artashesamatuni/coreEVSE/codechange.md

# Заметки для изменений прошивки OpenEVSE

Состояние на 2026-10-01. Это план для `../coreEVSE-Soft/firmware`, основанный на текущих схемах `evse.kicad_sch`, `weld.kicad_sch` и исходном коде. Прошивка этим документом не изменена. Оба канала контроля выхода объединены на штатном `WELD_DETECT` (PD3); PB1 освобождён. Плату и разводку нужно обновить позже.

## Выводы ATmega328P-AU (U4)

| Вывод U4 | Схема | Текущий код | Вывод |
| --- | --- | --- | --- |
| PD7, площадка 11 | R31 10 кОм к +5 В | `targets/m328p/target.cpp:125-165`: определяет плату V6 вместе с ADC6 | Занят, нельзя использовать как свободный вход без переделки определения платы. |
| ADC6, площадка 19 | R22 10 кОм к +5 В | Там же: значение >1000 определяет CGMI | Занят идентификацией платы. Комментарий в коде говорит о 330 Ом, схема содержит 10 кОм; исправить комментарий при правке кода. |
| ADC7, площадка 22 | Электрически не подключён | Не используется | Остаётся свободным аналоговым входом. У ATmega328P-AU это **только аналоговый вход**; для будущего применения потребуется внешняя подтяжка. |
| PC3, площадка 26 | Электрически не подключён | `targets/m328p/pindefs.h:20-22`, `open_evse/main.cpp:985-986`: вход кнопки с подтяжкой | Можно занять вторым входом только после переноса/отключения кнопки и удаления конфликта в коде. |
| PB1, площадка 13 | Электрически не подключён | Пока ещё выход AC-реле в `targets/m328p/pindefs.h:71-73` и `open_evse/J1772EvseController.cpp:1181` | AC-реле в проекте не будет; удалить его назначение в будущей версии кода. Для контроля залипания PB1 не нужен. |
| PD5/PD6, площадки 9/10 | Управление K1/K2 | `V6_CHARGING_PIN` / `V6_CHARGING_PIN2` | Оставить выходами катушек. |
| PD3/PD4, площадки 1/2 | `WELD_DETECT` / `GMI_LINE` | Входы `ReadACPins()` | Сохранять существующий контроль напряжения и земли. |

**Ответ по PD7:** это аппаратный признак версии платы. При PD7=1 и ADC6=1 прошивка выбирает V6 с CGMI (`g_isV6`, `g_hasCGMI`). Если использовать PD7 как другой вход, может измениться ветка управления реле и контроля AC. Канал IC9 для K2 объединён с PD3; PB1 и ADC7 остаются свободными выводами схемы.

## Как сейчас управляются K1 и K2

- `open_evse/open_evse.h:72-74,339-340`: включены `OEV6`, `RELAY_PWM`, настройка длительности полного включения и удержания. Значения по умолчанию: 100 мс полного питания и PWM 255/255 (100%). Сохранённые значения EEPROM могут отличаться.
- `targets/m328p/pindefs.h:62-63` назначает PD5 и PD6. `open_evse/J1772EvseController.cpp:429-476` подаёт HIGH на разрешённые реле, ждёт `m_relayCloseMs`, затем задаёт общий `m_relayHoldPwm`; `:479-517` снимает питание с обоих. Флаги разрешения реле хранятся отдельно (`J1772EvseController.h:95-99`).
- AC-реле отсутствует. Убрать из целевой конфигурации `CHARGINGAC_REG/CHARGINGAC_IDX`, инициализацию `pinChargingAC`, включение/выключение `pinChargingAC` и применение флага `ERELAYF_AC_DISABLED`. PB1 в схеме не подключён; не назначать ему датчик залипания. Проверить все ветки сборки и функции пилота, использующие PB1.
- Команда RAPI `Z0` меняет параметры и записывает их в EEPROM (`open_evse/rapi_proc.cpp:919-937`). При изменении прошивки проверить диапазоны, отказобезопасные значения и обработку некорректных данных EEPROM.
- Для HF186F/12-HTF сохранить начальное полное питание катушки не менее требуемых 100 мс. Намеченные 70% PWM — только начальная гипотеза: скважность ШИМ не равна напряжению удержания катушки, а допустимое удержание зависит от температуры, питания и цепи свободного хода. По паспорту HF186F при 105 °C приведён диапазон 45–55% номинального напряжения удержания; фиксированные 70% требуют проверки нагрева. Измерить ток/температуру катушки и надёжность удержания во всём диапазоне питания и температуры, затем зафиксировать проверенные параметры в коде/EEPROM.
- Проверить ограничение разрешённого зарядного тока относительно реально подтверждённой коммутационной способности реле, соединителей, дорожек и теплового режима. В `open_evse/open_evse.h:483-484` значение `MAX_CURRENT_CAPACITY_L2` по умолчанию 80 А, если сборка не переопределяет его; это само по себе не подтверждает допустимость 80 А для данной схемы. Для HF186F указаны разные значения длительного тока и тока коммутации.

## Что сейчас делает WELD DETECT

- `WELD_DETECT` на PD3 через оптрон сообщает о напряжении на выходной стороне AC относительно PE; `GMI_LINE` на PD4 служит для контроля сети/земли. `ReadACPins()` (`open_evse/J1772EvseController.cpp:841-867`) считает оптовходы активными низким уровнем и опрашивает их до 20 мс (`open_evse.h:561`).
- `GMI_LINE` формируется каналом 1 IC8: `ACLIN` и `ACNIN` через отдельные резисторы/диоды относительно PE, выход — PD4. При наличии напряжения входной сети относительно PE оптрон периодически тянет PD4 вниз. `J1772EvseController.cpp:1552-1558` по отсутствию этого признака в режиме CGMI выдаёт `EVSE_STATE_NO_GROUND`. Тот же сигнал используется в `measureAcFreq()` (`:136-233`) для частоты сети и привязки момента переключения реле к переходу через ноль. Это проверка наличия опорного напряжения относительно PE, а не измерение сопротивления защитного проводника; отсутствие входной сети также убирает сигнал.
- При старте POST проверяет реле в состоянии OFF (`J1772EvseController.cpp:1075-1085`). При наличии напряжения на выходе и включённой проверке залипания выставляется `SR`.
- Во время работы, после команды ON и задержки 1000 мс, отсутствие ожидаемого сигнала на PD3 вызывает `EVSE_STATE_RELAY_CLOSURE_FAULT` (`J1772EvseController.cpp:1570-1578`). После команды OFF напряжение на PD3 должно отсутствовать; если оно сохраняется более 1000 мс после отключения и более 1000 мс от начала наблюдения, выставляется `EVSE_STATE_STUCK_RELAY` (`:1629-1648`). При включённом `UL_COMPLIANT` этот отказ приводит к `HardFault` (`:1984-1990`).
- Проверка зависит от `StuckRelayChkEnabled()` и может быть отключена настройкой. Для новой схемы обратной связи нужно определить безопасную политику конфигурации: диагностический контроль контактов не должен случайно отключаться обычной настройкой.
- **Ограничение исходной схемы OpenEVSE:** ветвь `AC_N_OUT–PE` не гарантирует обнаружение залипшего K2 при 230 В L–N, когда K1 разомкнут: нейтраль близка к PE. Поэтому добавлен второй оптрон IC9, выход которого объединён с тем же PD3. Прошивка не различает, какой контакт залип, и выдаёт общую ошибку.
- В `weld.kicad_sch` вход IC8 от `ACNIN–PE` объединён с `ACLIN–PE` в `GMI_LINE`, а вход от `AC_N_OUT–PE` объединён с `AC_L_OUT–PE` в `WELD_DETECT`. Они не дают раздельного цифрового признака положения нейтрального контакта. Даже отдельные измерения `ACNIN–PE` и `AC_N_OUT–PE` не являются надёжным тестом залипания K2: при замкнутой нейтрали оба напряжения обычно малы, а разомкнутый `AC_N_OUT` может плавать и иметь такое же напряжение относительно PE. Значение N–PE также зависит от нагрузки и падения напряжения в проводе нейтрали.

## Добавленный аппаратный канал для K2

- В `weld.kicad_sch` IC9 (HCPL-4731-500E) контролирует напряжение **между `ACLIN` и `AC_N_OUT`**. R44 и R45 по 180 кОм ограничивают сетевой ток; D13 шунтирует обратное напряжение входного светодиода; C37 100 нФ развязывает питание IC9; R46 10 кОм подтягивает выход к +5 В. Используется канал 2 IC9, канал 1 отмечен как неиспользуемый.
- Выходы IC9 P$6 и исходного IC8 P$6 объединены по схеме «открытый коллектор» на `WELD_DETECT` / PD3 U4. Общая R46 10 кОм подтягивает линию к +5 В; сигнал активен низким уровнем. PB1 не подключён. При исправной входной сети и замкнутом K2 на входе IC9 есть сетевое напряжение; при разомкнутом K2 в состоянии OFF ожидается отсутствие сигнала. Если K2 залип при разомкнутом K1, IC9 должен активировать тот же вход и ту же ошибку, что IC8 для K1.
- Входная сеть должна присутствовать для достоверной проверки IC9. GMI остаётся отдельным сигналом; потеря входной сети не должна интерпретироваться как подтверждение разомкнутых контактов.
- Новый датчик **измеряет напряжение, а не механическое положение K2**. Если `AC_N_OUT` связан с входной нейтралью через внешнюю цепь, возможен ложный сигнал залипания. Если `ACLIN` обесточена или цепь датчика оборвана, отсутствие сигнала не доказывает разомкнутость K2. Для доказательства положения контакта потребуется реле/контактор с сертифицированным зеркальным вспомогательным контактом; у текущего HF186F такого контакта нет. Проверить утечку через измерительную цепь, изоляционные расстояния, номиналы резисторов и работу с подключённым автомобилем до изготовления платы.

## Расчёт цепи WELD при 230 В, 50 Гц

Приняты 207–253 В RMS (±10%), синусоида, R32–R39 и R44–R45 по 180 кОм ±1%, приблизительно 2 В суммарного падения на входном светодиоде и последовательном диоде. Каждая измерительная ветвь имеет 360 кОм. Числа ниже относятся к схеме, а не подтверждают её работу после сборки.

| Напряжение | Пиковый ток ветви | Время за период 20 мс с током LED ≥0,5 мА | Мощность одного резистора исходной полуволновой ветви | Мощность R44/R45 в канале IC9 |
| --- | ---: | ---: | ---: | ---: |
| 207 В | 0,808 мА | 5,75 мс | 29,8 мВт | 59,5 мВт |
| 230 В | 0,898 мА | 6,24 мс | 36,7 мВт | 73,5 мВт |
| 253 В | 0,988 мА | 6,62 мс | 44,5 мВт | 88,9 мВт |

У IC9 обратный полупериод проводит D13, поэтому его резисторы нагружены на обеих полуволнах; ток LED есть только на прямой. Оценка RMS тока этой ветви при 253 В — 0,703 мА. Для полуволновой ветви IC8 через PE — около 0,497 мА RMS при 253 В. В обычном режиме с замкнутым K1 две фазные ветви IC8 (GMI и WELD) могут суммарно дать около 1 мА RMS в PE при 253 В; нужно измерить общий ток PE с остальными цепями и проверить допустимость для изделия. IC9 ток в PE не направляет.

R46 10 кОм даёт ток коллектора примерно 0,5 мА при LOW и рассеивает не более 2,5 мВт; внутренняя подтяжка МК добавляет ток. По паспорту HCPL-4731 гарантирован `VOL ≤ 0,4 В` при `IF = 0,5 мА` и `IO = 2,5 мА`, что оставляет запас для R46. При худших 207 В и +1% сопротивления пик остаётся около 0,80 мА. Длительность импульса выше 0,5 мА превышает 5 мс; накопление события за 20 мс в `ReadACPins()` должно его увидеть. Требуется испытание при сетевых помехах, с автомобилем и при всех температурах.

Резистор KOA HV73 тип 3A/2512 имеет паспортные 1 Вт при 70 °C и максимальное рабочее 3000 В DC; расчётная мощность менее 0,09 Вт на резистор. Диоды S1M имеют `VRRM = 1000 В`, пик синусоиды 253 В RMS составляет 358 В. Это проверка номиналов элементов; зазоры, импульсные перенапряжения, тепловой режим и изоляцию платы отдельно не проверяли. HCPL-4731 нормирован по рабочим параметрам до 70 °C, что особенно важно рядом с силовой цепью 50 А.

## Что учесть в прошивке для общего WELD_DETECT

1. Новый вход МК не требуется. Сохранить чтение PD3 в `ReadACPins()` в течение полного периода сети (20 мс для 50 Гц). LOW означает активность любого из двух оптронов. Не вводить `WELD_N_DETECT` и не использовать PB1 для датчика.
2. Сохранить существующие POST и проверку OFF: при наличии входной сети по GMI активный `WELD_DETECT` означает общую ошибку залипания/внешнего напряжения на выходе. После команды OFF выдержать задержку отпускания и подтвердить, что сигнал пропал. При ошибке снять питание обеих катушек и запретить зарядку; невозможно определить виновный контакт по одному входу.
3. Сохранить проверку ON, но учитывать, что общий сигнал доказывает лишь наличие напряжения хотя бы в одном канале: замыкание каждого контакта по отдельности он не подтверждает. Не объявлять контакты исправными по неактивному WELD, если пропала входная сеть/GMI.
4. Для серийной конфигурации исключить случайное отключение проверки `StuckRelayChkEnabled()`. Проверить, что состояние `STUCK_RELAY` фиксируется и не приводит к автоматическому возобновлению зарядки. Сохранить независимую диагностику GMI и отдельную обработку отсутствия PE/входной сети.
5. AC-реле в проекте отсутствует: при будущей правке кода убрать его назначение на PB1 и ветви управления. Это не требуется для электрической совместимости текущего канала WELD, поскольку PB1 к нему больше не подключён.

**Точки интеграции при будущей правке:** `targets/m328p/pindefs.h` (удаление AC-реле с PB1), `targets/m328p/target.cpp` (сохранение PD7/ADC6), `open_evse/J1772EvseController.cpp` (`ReadACPins`, POST, OFF/ON диагностика), `open_evse/open_evse.h` (время опроса), UI/RAPI (общая ошибка). Дополнительные диагностические биты K1/K2 не нужны.

## Проверки после реализации

- OFF и ON обоих реле; отдельное залипание K1, отдельное залипание K2, залипание обоих.
- Обрыв/замыкание входных ветвей IC8/IC9, отсутствие входной фазы, внешнее соединение `AC_N_OUT` с N/PE, подключённый автомобиль и длинный кабель; все комбинации с K1/K2 OFF и ON. Проверить, что любой из двух оптронов отдельно тянет PD3 вниз.
- Исчезновение и возврат сети, потеря PE, старт после обесточивания и перезапуск МК при включённой зарядке.
- Минимум/максимум питания катушек, холодный/горячий режим и заданный PWM удержания; подтверждение тока и температуры при длительной работе.
- Проверка, что неисправность всегда снимает команды с K1/K2, не допускает автоматического возобновления опасного состояния и остаётся видимой в интерфейсе.

## Варианты следующей ревизии аппаратной диагностики

1. **Предпочтительный:** K1 и K2 заменить двумя аппаратами с сертифицированными NC зеркальными контактами. Два раздельных низковольтных входа контролируют положение каждого полюса; существующие/новые изолированные измерения выходного напряжения остаются независимой перекрёстной проверкой. Для PE нужен отдельный контроллер непрерывности/импеданса защитного проводника с контролируемым тестовым воздействием и проверкой входного питания. Проверять также PE на выходном разъёме: измерение только на общей площадке платы не обнаружит обрыв кабеля/клеммы после неё. Требуется выбрать аппарат по реальному зарядному току, коммутационной способности и типу сети.
2. **Сохранить HF186F:** раздельно измерять `AC_L_OUT–ACNIN` для K1 и `ACLIN–AC_N_OUT` для K2, с определённым смещением плавающих выходов и проверкой при разных состояниях нагрузки. Добавить независимую проверку PE. Такой подход даёт диагностику наличия напряжения, но внешние связи/ёмкости и обрыв самой измерительной цепи не позволяют считать его доказательством механического положения контакта. Нужны испытания с автомобилем, кабелем, помехами, всеми вариантами питания и ошибок.
3. **Специализированный контроллер EVSE/безопасности:** использовать измерительный узел с отдельными входами до/после контактов и функцией контроля PE/PEN, соответствующий конкретной TN-S/TN-C-S/TT схеме и требованиям установки. Отдельно верифицировать состояние каждого полюса и выводить отказ в аппаратное запрещение катушек.

Одноканальный оптрон подходит **для одного независимого канала измерения напряжения**. Например, у Broadcom HCPL-4701 один канал, но гарантированные параметры указанной серии ограничены 0…70 °C. Более широкий диапазон имеет ACPL-M417T (–40…125 °C, минимальный рабочий ток входа 0,3 мА); его резисторы, полярность, выходную подтяжку и изоляционные расстояния необходимо рассчитывать заново. Зеркальный сухой контакт может входить прямо в низковольтный диагностический вход без оптрона, с контролем обрыва и замыкания линии. Один оптрон на все три отказа не позволяет различить K1, K2 и PE.

## Источники

- Схема: `evse.kicad_sch`, `weld.kicad_sch`, `relay_control.kicad_sch`; прошивка: `../coreEVSE-Soft/firmware/`.
- [Исходная схема OpenEVSE PLUS v6.5.1](https://github.com/OpenEVSE/OpenEVSE_PLUS/tree/master/OpenEVSE_PLUS_v6.5.1): два выхода AC через отдельные резисторы и диоды на один канал WELD относительно PE. Сохранён этот канал; добавленный IC9 для нейтрали является осознанным дополнением для сети L–N 230 В, а не буквальной копией оригинала.
- [Microchip ATmega328P: ADC7/ADC6 доступны как аналоговые входы в TQFP](https://onlinedocs.microchip.com/oxy/GUID-80B1922D-872B-40C8-A8A5-0CBE009FD908-en-US-3/GUID-AC1FBED3-2DF1-410C-BA80-A15E1E68FED4.html).
- [Hongfa HF186F, паспорт](https://source.hongfa.com/Api/DownloadPdf/635).
- [Broadcom HCPL-4731, паспорт](https://docs.broadcom.com/doc/AV01-0547EN). Гарантированные параметры входного тока/CTR в нём указаны для 0…70 °C; проверить применимость выбранного оптрона к ожидаемой температуре устройства.
- [KOA HV73, паспорт резисторов](https://www.koaspeer.com/pdfs/HV73.pdf); [Diodes S1M, паспорт диодов](https://www.diodes.com/datasheet/download/S1M.pdf).
- [Schneider Electric: назначение сертифицированного зеркального NC-контакта](https://www.se.com/uk/en/faqs/FA142116/).
- [Broadcom ACPL-M417T, паспорт одноканального оптрона](https://docs.broadcom.com/doc/ACPL-M417T-DS).
- [Analog Devices: контроль PE и залипания в EVSE](https://wiki.analog.com/resources/eval/user-guides/ade9178).
