artashesamatuni/coreEVSE/todo.txt

coreEVSE — обязательно исправить
Статус проверен по evse.kicad_sch: 2026-09-25

[ ] 1. Повысить рабочее напряжение C5, C6, C10, C13 и C26.
    Сейчас: 10 uF, 10 V, X7R.
    Требуется: 10 uF, не менее 25 V, X7R; выбрать точный MPN и проверить
    эффективную емкость с учетом DC-bias. Конденсаторы работают на шинах
    +12 V, -12 V либо в charge-pump TC1044S.

[x] 2. Исправить кварцевый генератор ATmega328P-AU.
    Выполнено: Y1 = FA-238A, 16 MHz, CL=8 pF, корпус 3.2 x 2.5 mm;
    C1=C2=12 pF, C0G/NP0, 50 V, 0402. Корпус и параметры согласованы.

[ ] 3. Зафиксировать адрес MCP9808 (U3).
    Соединить A0, A1 и A2 с GND для адреса 0x18.
    Неиспользуемый Alert оставить явно отмеченным No Connect.

[ ] 4. Гарантировать выключение реле при Reset.
    Добавить по одному резистору 47-100 kOhm между базой и эмиттером
    Q2 и Q3. Это должно удерживать реле выключенными при reset,
    программировании и высокоимпедансных выводах MCU.

[ ] 5. Выбрать и указать точные MOV для M1-M3.
    Для каждого указать MPN, рабочее AC-напряжение, varistor voltage,
    clamping voltage, энергию, импульсный ток, температурный диапазон,
    safety approvals и координацию с предохранителем/внешним автоматом.
    Отдельно проверить допустимость и ток утечки для M2/M3 между L/N и PE.

[ ] 6. Заменить D7-D10.
    Вместо 1N4004 применить 1N4007 либо эквивалентный SMD-диод с
    VRRM не менее 1000 V. Указать точный MPN, datasheet и корректное описание.

[ ] 7. Определить точные сетевые резисторы R32-R39.
    Для номинала 180 kOhm выбрать MPN и указать допуск (желательно 1%),
    мощность, maximum working voltage, overload/pulse rating и creepage
    выбранного корпуса. Расчетно каждый резистор рассеивает около 73 mW,
    но пригодность нельзя определять только по мощности и размеру 1210.

После выполнения:
- повторно экспортировать netlist и запустить ERC без ошибок;
- проверить соответствие схемы и PCB;
- выполнить worst-case расчеты и стендовые проверки затронутых узлов.
