artashesamatuni/coreEVSE/evse.kicad_pcb

## KiCad design evse.kicad_pcb (2026-10-02)

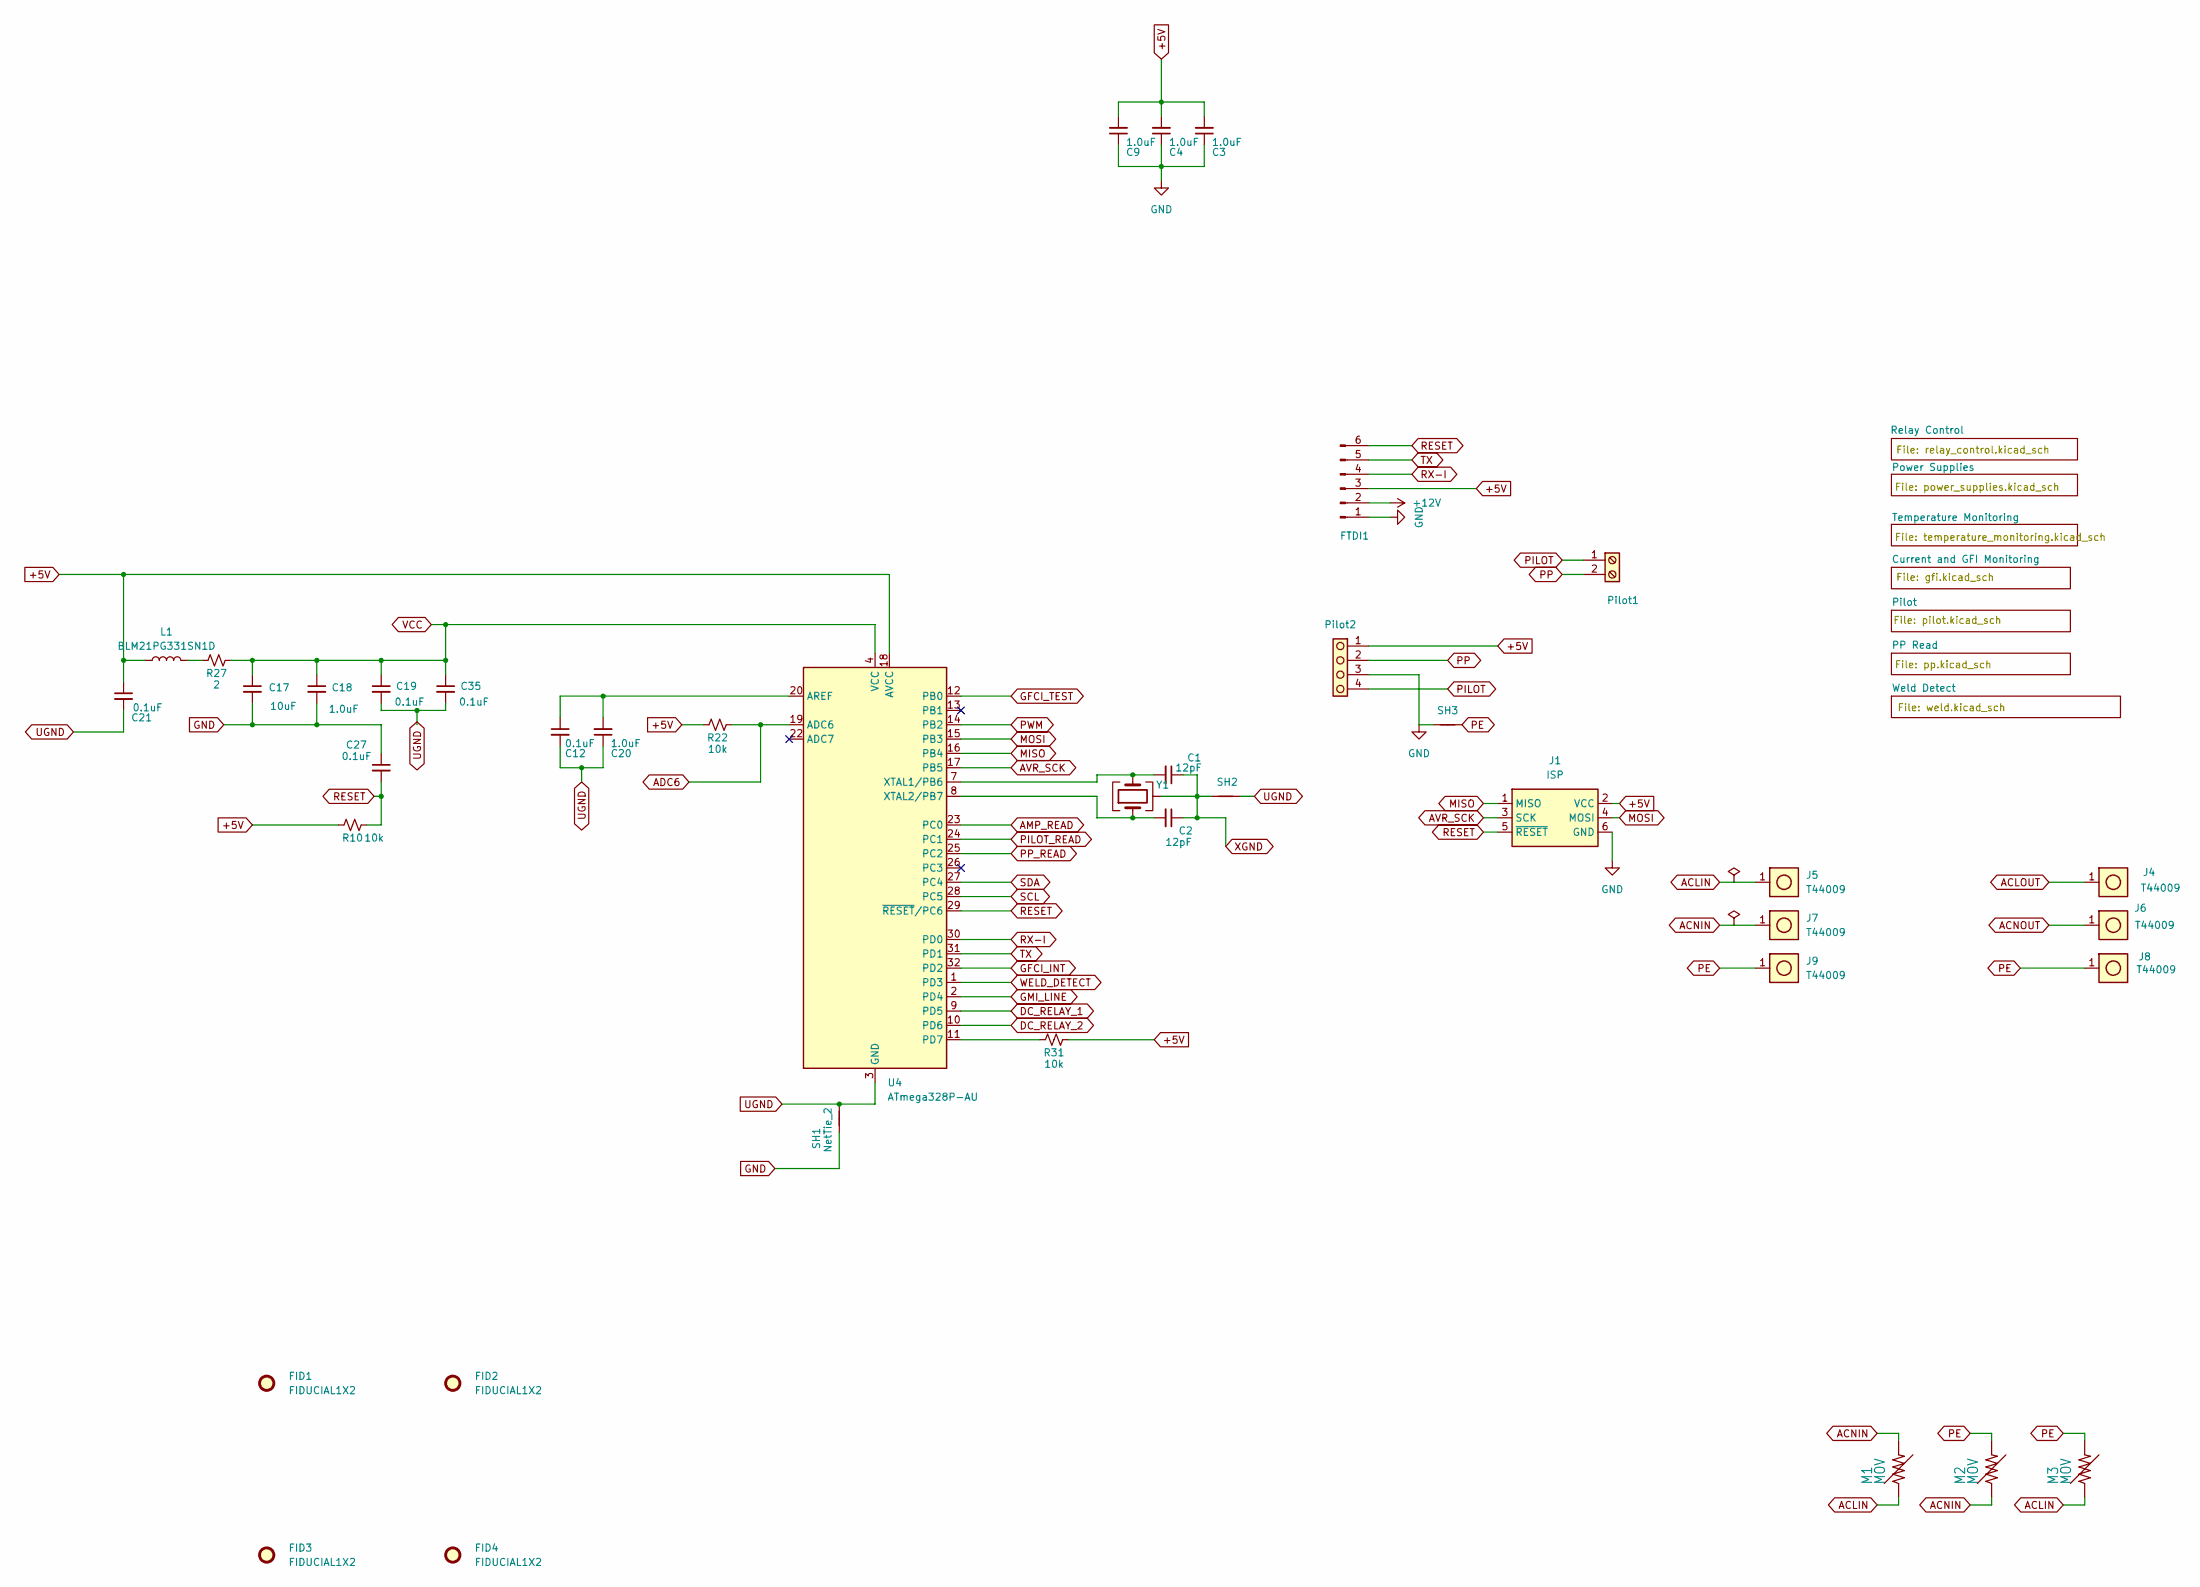
[picture p1: schematic evse.kicad_sch]

Parts:
C1, C2: 12pF; C_0402_1005Metric; Voltage 50V; Tolerance 2%; LCSC C696888
C3, C4, C9, C20: 1.0uF; C_0805_2012Metric; Voltage 25V; Tolerance 10%; LCSC C3848979
C12, C19, C21, C27: 0.1uF; C_0805_2012Metric; Voltage 25V; Tolerance 10%; LCSC C129641
C17: 10uF; C_0603_1608Metric_Polar; Voltage 10V; Tolerance 20%
C18: 1.0uF; C_0201_0603Metric; Voltage 25V; Tolerance 10%
C35: 0.1uF; C_0402_1005Metric; Voltage 25V; Tolerance 10%; LCSC C169842
FID1, FID2, FID3, FID4: FIDUCIAL1X2; Fiducial_1mm_Mask2mm
FTDI1: Conn_01x06_Pin; FTDI_JST_PH_1x06_P2.00mm
J1: ISP; AVR_ISP_2x03_P2.54mm
J4, J5, J6, J7, J8, J9: T44009; Terminal_T44009_M4
L1: BLM21PG331SN1D; L_0805_2012Metric; LCSC C74764
M1, M2, M3: MOV
Pilot1: KF128-2.54-2P; TerminalBlock_KF128-2.54-2P; LCSC C474920
Pilot2: KF128-2.54-4P; TerminalBlock_KF128-2.54-4P; LCSC C474922
R10, R22, R31: 10k; R_0805_2012Metric; LCSC C7337170
R27: 2; R_0805_2012Metric; LCSC C2078467
SH1, SH2, SH3: NetTie_2; NetTie-2_SMD_Pad0.5mm
U4: ATmega328P-AU; TQFP-32_7x7mm_P0.8mm; Operating Voltage Range 1.8V~5.5V; Low Voltage Detection T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 1.8V~5.5V; Part ATMEGA328P-AU; LCSC C14877
Y1: FA-238A 16MHz CL=8pF; Crystal_SMD_SeikoEpson_TSX3225-4Pin_3.2x2.5mm

Connections:
+5V: C3.2, C4.2, C9.2, C21.1, FTDI1.3, J1.2 (VCC), L1.1, Pilot2.1, R10.1, R22.1, R31.2, U4.18 (AVCC); also elsewhere on the board
+12V: FTDI1.2; also elsewhere on the board
ACLIN: J5.1 (Terminal_1), M1.P$1 (1), M3.P$1 (1); also elsewhere on the board
ACNIN: J7.1 (Terminal_1), M1.P$2 (2), M2.P$1 (1); also elsewhere on the board
AC_L_OUT: J4.1 (Terminal_1); also elsewhere on the board
AC_N_OUT: J6.1 (Terminal_1); also elsewhere on the board
ADC6: R22.2, U4.19 (ADC6)
AMP_READ: U4.23 (PC0); also elsewhere on the board
AVR_SCK: J1.3 (SCK), U4.17 (PB5)
DC_RELAY_1: U4.9 (PD5); also elsewhere on the board
DC_RELAY_2: U4.10 (PD6); also elsewhere on the board
GFCI_INT: U4.32 (PD2); also elsewhere on the board
GFCI_TEST: U4.12 (PB0); also elsewhere on the board
GMI_LINE: U4.2 (PD4); also elsewhere on the board
GND: C3.1, C4.1, C9.1, C17.2, C18.2, C27.1, FTDI1.1, J1.6 (GND), Pilot2.3, SH1.1, SH3.1; also elsewhere on the board
MISO: J1.1 (MISO), U4.16 (PB4)
MOSI: J1.4 (MOSI), U4.15 (PB3)
unnamed: L1.2, R27.1
unnamed: R31.1, U4.11 (PD7)
unnamed: C1.2, U4.7 (XTAL1/PB6), Y1.3
unnamed: C2.2, U4.8 (XTAL2/PB7), Y1.1
PE: J8.1 (Terminal_1), J9.1 (Terminal_1), M2.P$2 (2), M3.P$2 (2), SH3.2; also elsewhere on the board
PILOT: Pilot1.1, Pilot2.4; also elsewhere on the board
PILOT_READ: U4.24 (PC1); also elsewhere on the board
PP: Pilot1.2, Pilot2.2; also elsewhere on the board
PP_READ: U4.25 (PC2); also elsewhere on the board
PWM: U4.14 (PB2); also elsewhere on the board
RESET: C27.2, FTDI1.6, J1.5 (~RESET), R10.2, U4.29 (~RESET/PC6)
RX-I: FTDI1.4, U4.30 (PD0)
SCL: U4.28 (PC5); also elsewhere on the board
SDA: U4.27 (PC4); also elsewhere on the board
TX: FTDI1.5, U4.31 (PD1)
VCC: C17.1, C18.1, C19.1, C35.1, R27.2, U4.4 (VCC), U4.6 (VCC)
WELD_DETECT: U4.1 (PD3); also elsewhere on the board
XGND: C1.1, C2.1, SH2.2, Y1.2 (G), Y1.4 (G)

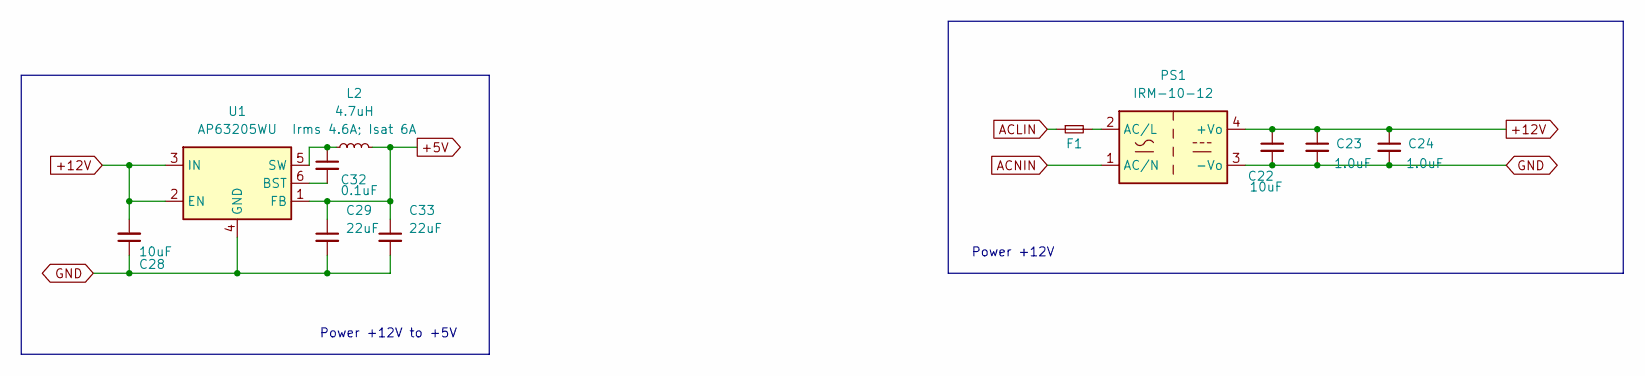
[picture p2: schematic power_supplies.kicad_sch, EVSE - Power Supplies]

Parts:
C22: 10uF; C_1206_3216Metric; Voltage 25V; Tolerance 10%; LCSC C380364
C23, C24: 1.0uF; C_0805_2012Metric; Voltage 25V; Tolerance 10%; LCSC C3848979
C28: 10uF; C_0805_2012Metric; Voltage 25V; Tolerance 10%; LCSC C5448891
C29, C33: 22uF; C_0805_2012Metric; Voltage 16V; Tolerance 20%; LCSC C380339
C32: 0.1uF; C_0805_2012Metric; Voltage 16V; Tolerance 10%; LCSC C129641
F1: 1.6A 250VAC slow-blow; BELFUSE1A
L2: 4.7uH; L_Bourns_SRP5030T; LCSC C2045677
PS1: IRM-10-12; Converter_ACDC_MeanWell_IRM-10-12_THT
U1: AP63205WU; TSOT-23-6

Connections:
+5V: C29.1, C33.1, L2.2, U1.1 (FB); also elsewhere on the board
+12V: C22.1, C23.1, C24.1, C28.2, PS1.4 (+Vo), U1.2 (EN), U1.3 (IN); also elsewhere on the board
ACLIN: F1.1; also elsewhere on the board
ACNIN: PS1.1 (AC/N); also elsewhere on the board
GND: C22.2, C23.2, C24.2, C28.1, C29.2, C33.2, PS1.3 (-Vo), U1.4 (GND); also elsewhere on the board
unnamed: F1.2, PS1.2 (AC/L)
unnamed: C32.2, U1.6 (BST)
unnamed: C32.1, L2.1, U1.5 (SW)

Notes on the sheet:
Power +12V
Power +12V to +5V

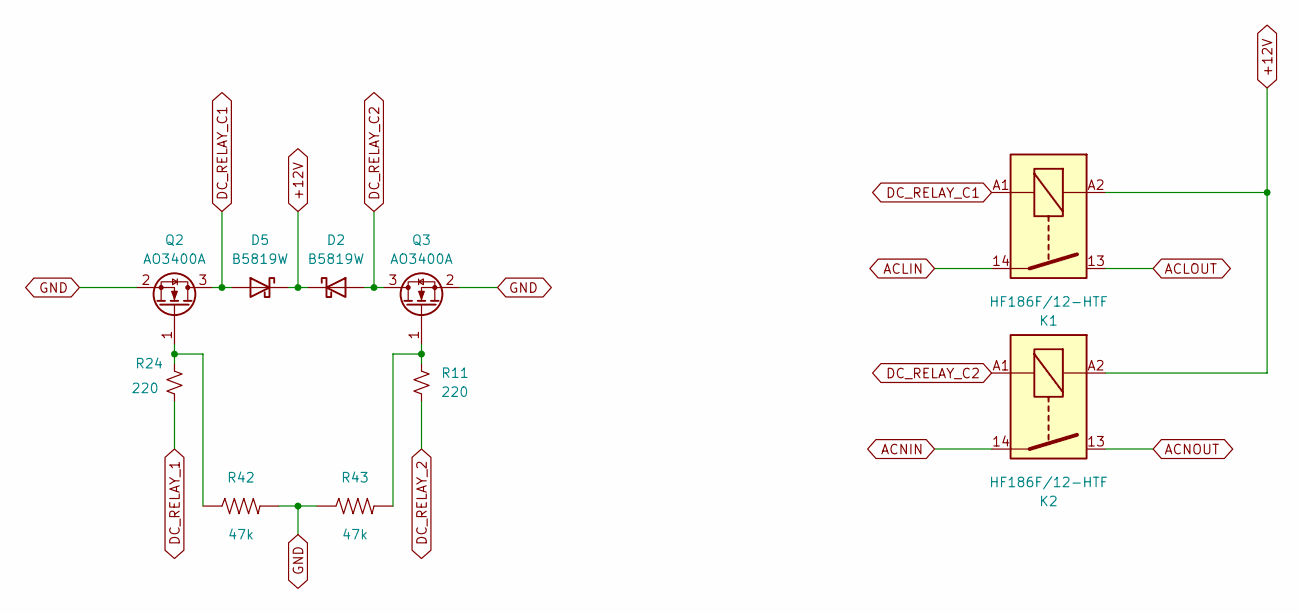
[picture p3: schematic relay_control.kicad_sch, EVSE - Relay Control]

Parts:
D2, D5: B5819W; D_SOD-123; LCSC C64885
K1, K2: HF186F/12-HTF; Relay_Hongfa_HF186F_PushIn; LCSC C6388924
Q2, Q3: AO3400A; SOT-23; LCSC C2803353
R11, R24: 220; R_0805_2012Metric; LCSC C17557
R42, R43: 47k; R_0805_2012Metric; LCSC C4238470

Connections:
+12V: D2.1 (K), D5.1 (K), K1.A2, K2.A2; also elsewhere on the board
ACLIN: K1.14; also elsewhere on the board
ACNIN: K2.14; also elsewhere on the board
AC_L_OUT: K1.13; also elsewhere on the board
AC_N_OUT: K2.13; also elsewhere on the board
DC_RELAY_1: R24.2; also elsewhere on the board
DC_RELAY_2: R11.1; also elsewhere on the board
DC_RELAY_C1: D5.2 (A), K1.A1, Q2.3 (D)
DC_RELAY_C2: D2.2 (A), K2.A1, Q3.3 (D)
GND: Q2.2 (S), Q3.2 (S), R42.2, R43.1; also elsewhere on the board
unnamed: Q2.1 (G), R24.1, R42.1
unnamed: Q3.1 (G), R11.2, R43.2

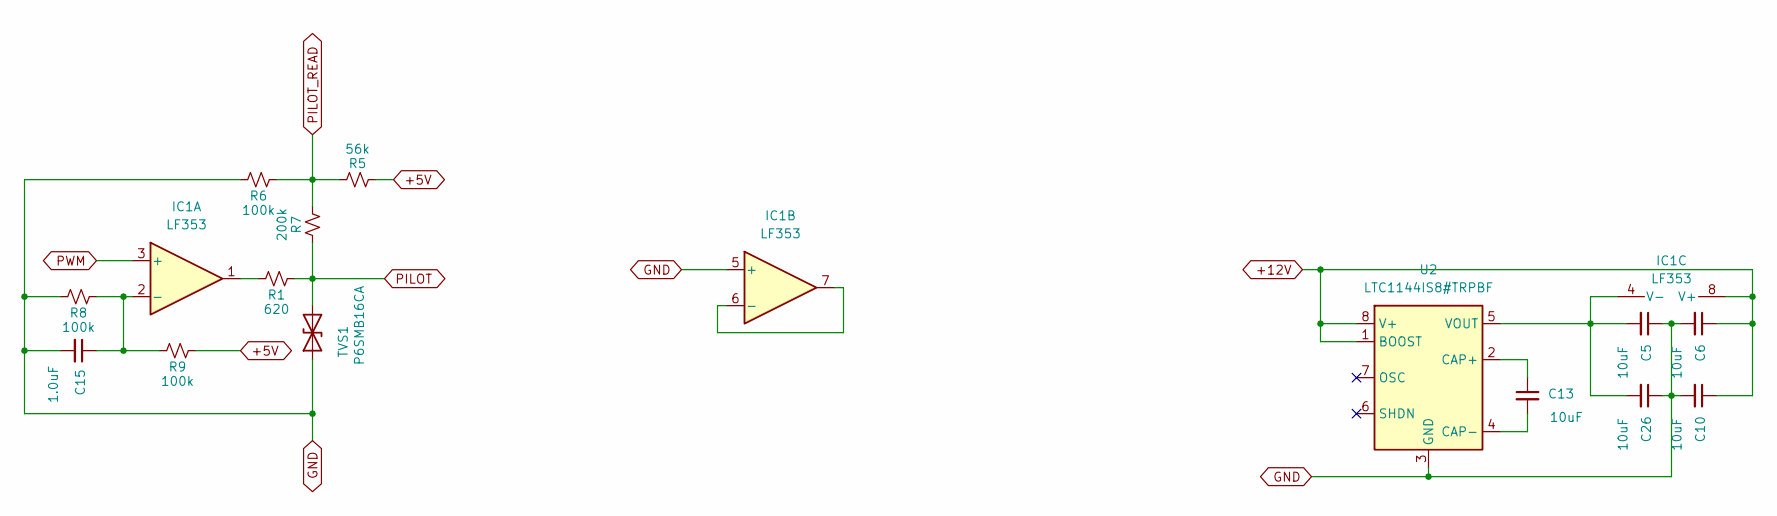
[picture p4: schematic pilot.kicad_sch]

Parts:
C5, C6, C10, C13, C26: 10uF; C_1210_3225Metric; Voltage 50V; Tolerance 10%; LCSC C17702790
C15: 1.0uF; C_0805_2012Metric; Voltage 25V; Tolerance 10%; LCSC C3848979
IC1: LF353; SOIC-8_3.9x4.9mm_P1.27mm
R1: 620; R_0805_2012Metric; LCSC C2907279
R5: 56k; R_0805_2012Metric; LCSC C4163131
R6, R8, R9: 100k; R_0805_2012Metric; LCSC C465471
R7: 200k; R_0805_2012Metric; LCSC C228624
TVS1: P6SMB16CA; SMB
U2: LTC1144IS8#TRPBF; SOIC-8_3.9x4.9mm_P1.27mm

Connections:
+5V: R5.1, R9.2; also elsewhere on the board
+12V: C6.1, C10.1, IC1.8 (V+), U2.1 (BOOST), U2.8 (V+); also elsewhere on the board
GND: C5.1, C6.2, C10.2, C15.2, C26.1, IC1.5 (+), R6.1, R8.1, TVS1.1 (A1), U2.3 (GND); also elsewhere on the board
unnamed: IC1.1, R1.1
unnamed: C15.1, IC1.2 (-), R8.2, R9.1
unnamed: IC1.6 (-), IC1.7
unnamed: C5.2, C26.2, IC1.4 (V-), U2.5 (VOUT)
unnamed: C13.1, U2.2 (CAP+)
unnamed: C13.2, U2.4 (CAP-)
PILOT: R1.2, R7.2, TVS1.2 (A2); also elsewhere on the board
PILOT_READ: R5.2, R6.2, R7.1; also elsewhere on the board
PWM: IC1.3 (+); also elsewhere on the board

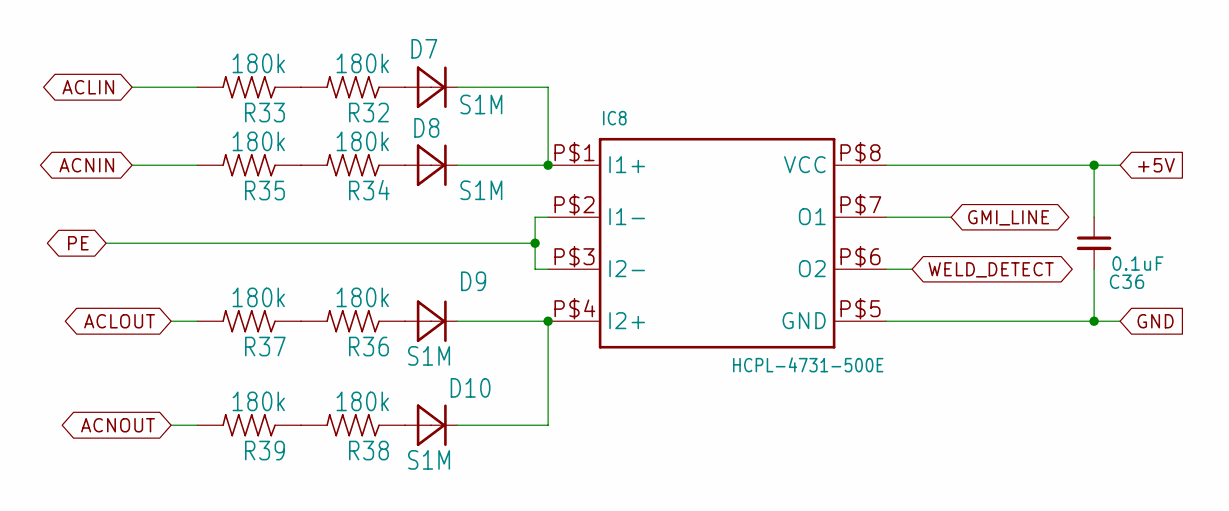
[picture p5: schematic weld.kicad_sch]

Parts:
C36: 0.1uF; C_0805_2012Metric; Voltage 25V; Tolerance 10%; LCSC C129641
D7, D8, D9, D10: S1M; SMA_AC
IC8: HCPL-4731-500E; SIL8-2; LCSC C692052
R32, R33, R34, R35, R36, R37, R38, R39: 180k; R_2512_6332Metric; Tolerance 1%; MPN HV733ATTE1803F

Connections:
+5V: C36.1, IC8.P$8 (VCC); also elsewhere on the board
ACLIN: R33.2; also elsewhere on the board
ACNIN: R35.2; also elsewhere on the board
AC_L_OUT: R37.2; also elsewhere on the board
AC_N_OUT: R39.2; also elsewhere on the board
GMI_LINE: IC8.P$7 (O1); also elsewhere on the board
GND: C36.2, IC8.P$5 (GND); also elsewhere on the board
unnamed: D7.A, R32.1
unnamed: D8.A, R34.1
unnamed: D9.A, R36.1
unnamed: D10.A, R38.1
unnamed: D7.C, D8.C, IC8.P$1 (I1+)
unnamed: D9.C, D10.C, IC8.P$4 (I2+)
unnamed: R32.2, R33.1
unnamed: R34.2, R35.1
unnamed: R36.2, R37.1
unnamed: R38.2, R39.1
PE: IC8.P$2 (I1-), IC8.P$3 (I2-); also elsewhere on the board
WELD_DETECT: IC8.P$6 (O2); also elsewhere on the board

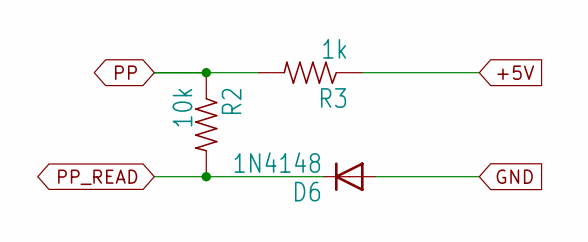
[picture p6: schematic pp.kicad_sch]

Parts:
D6: 1N4148; SOD-123_AC
R2: 10k; R_0805_2012Metric; LCSC C7337170
R3: 1k; R_0805_2012Metric; LCSC C2889437

Connections:
+5V: R3.1; also elsewhere on the board
GND: D6.A; also elsewhere on the board
PP: R2.1, R3.2; also elsewhere on the board
PP_READ: D6.C, R2.2; also elsewhere on the board

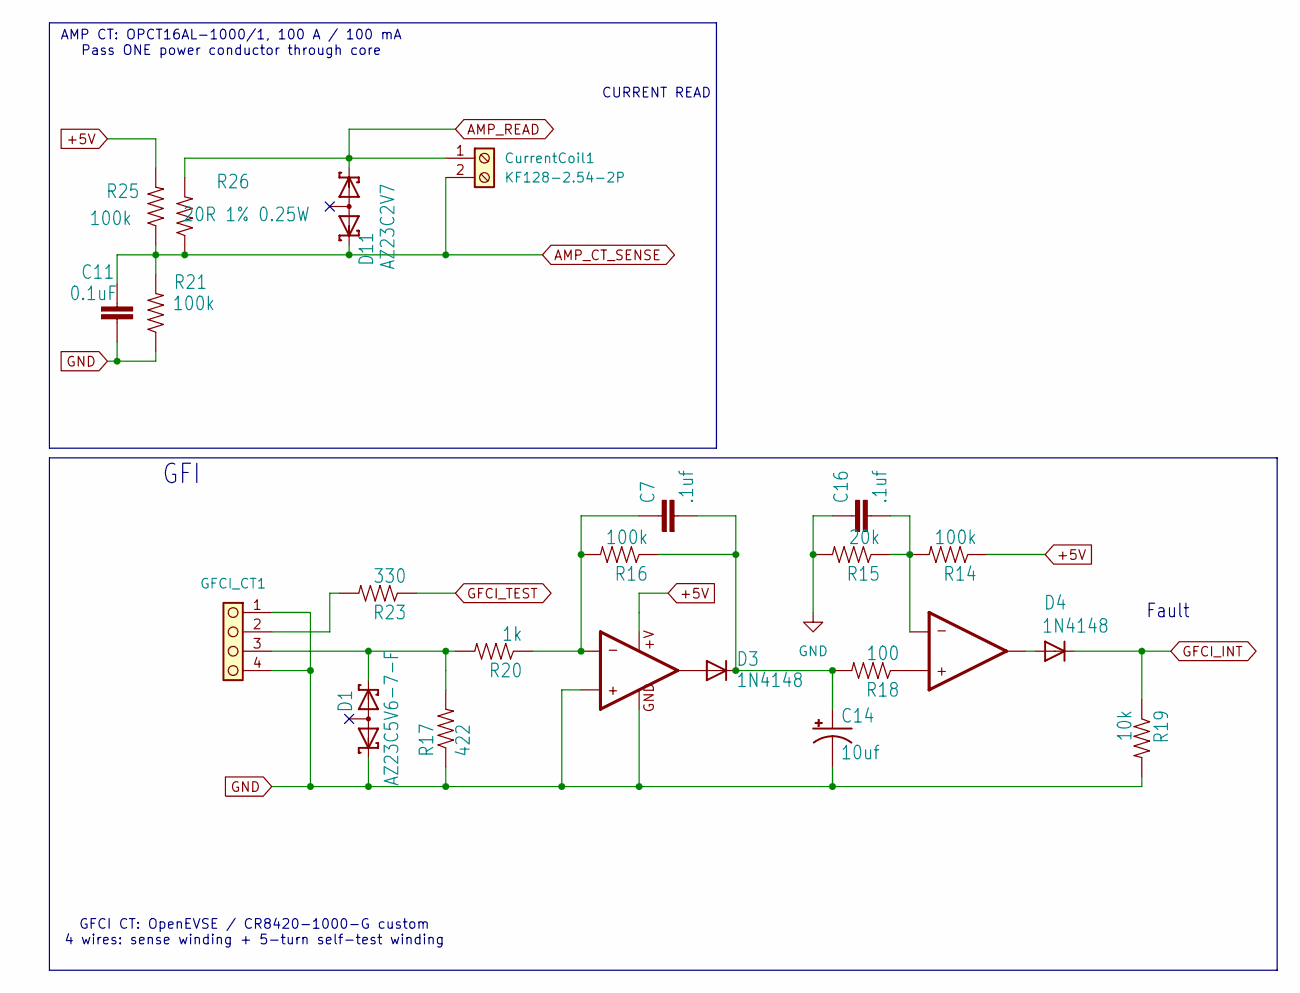
[picture p7: schematic gfi.kicad_sch]

Parts:
C7, C16: .1uf; C_0805_2012Metric; LCSC C129641
C11: 0.1uF; C_0805_2012Metric; LCSC C129641
C14: 10uf; C_1206_3216Metric_AC
CurrentCoil1: KF128-2.54-2P; TerminalBlock_KF128-2.54-2P; LCSC C474920
D1: AZ23C5V6-7-F; SOT-23
D3, D4: 1N4148; SOD-123_AC
D11: AZ23C2V7; SOT23-3
GFCI_CT1: KF128-2.54-4P; TerminalBlock_KF128-2.54-4P; LCSC C474922
IC3: LM358; SOIC-8_3.9x4.9mm_P1.27mm; LCSC C5423
R14, R16, R21, R25: 100k; R_0805_2012Metric; LCSC C465471
R15: 20k; R_0805_2012Metric; LCSC C114566
R17: 422; R_0805_2012Metric; LCSC C5635137
R18: 100; R_0805_2012Metric; LCSC C2889469
R19: 10k; R_0805_2012Metric; LCSC C7337170
R20: 1k; R_0805_2012Metric; LCSC C2889437
R23: 330; R_0805_2012Metric; LCSC C2889518
R26: 20R 1% 0.25W; R_0805_2012Metric; LCSC C363248

Connections:
+5V: IC3.8 (+V), R14.1, R25.2; also elsewhere on the board
AMP_CT_SENSE: C11.1, CurrentCoil1.2, D11.1 (K1), R21.2, R25.1, R26.1
AMP_READ: CurrentCoil1.1, D11.2 (K2), R26.2; also elsewhere on the board
GFCI_INT: D4.C, R19.1; also elsewhere on the board
GFCI_TEST: R23.1; also elsewhere on the board
GND: C11.2, C14.C (-), C16.1, D1.1 (K1), GFCI_CT1.1, GFCI_CT1.4, IC3.3 (+IN1), IC3.4 (GND), R15.2, R17.1, R19.2, R21.1; also elsewhere on the board
unnamed: C7.2, C14.A (+), D3.C, R16.1, R18.2
unnamed: D1.2 (K2), GFCI_CT1.3, R17.2, R20.2
unnamed: GFCI_CT1.2, R23.2
unnamed: C7.1, IC3.2 (-IN1), R16.2, R20.1
unnamed: D3.A, IC3.1 (OUT1)
unnamed: IC3.5 (+IN2), R18.1
unnamed: C16.2, IC3.6 (-IN2), R14.2, R15.1
unnamed: D4.A, IC3.7 (OUT2)

Notes on the sheet:
CURRENT READ
AMP CT: OPCT16AL-1000/1, 100 A / 100 mA Pass ONE power conductor through core
Fault
GFI
GFCI CT: OpenEVSE / CR8420-1000-G custom 4 wires: sense winding + 5-turn self-test winding

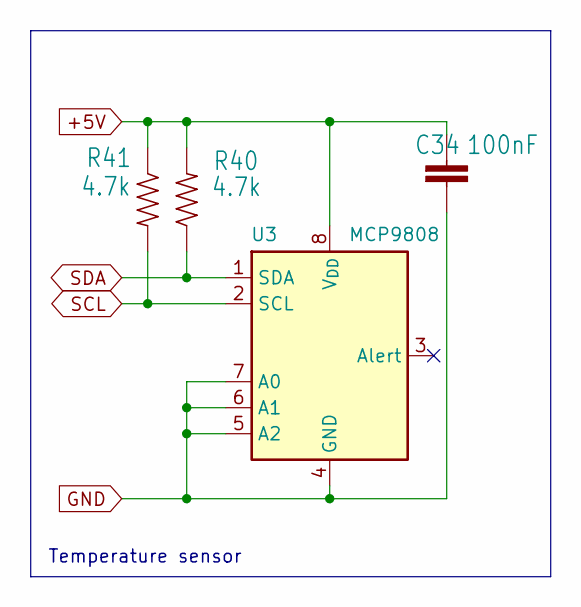
[picture p8: schematic temperature_monitoring.kicad_sch]

Parts:
C34: 100nF; C_0805_2012Metric; LCSC C129641
R40, R41: 4.7k; R_0805_2012Metric; LCSC C140869
U3: MCP9808; MSOP-8_3x3mm_P0.65mm

Connections:
+5V: C34.1, R40.2, R41.1, U3.8 (V_{DD}); also elsewhere on the board
GND: C34.2, U3.4 (GND), U3.5 (A2), U3.6 (A1), U3.7 (A0); also elsewhere on the board
SCL: R41.2, U3.2 (SCL); also elsewhere on the board
SDA: R40.1, U3.1 (SDA); also elsewhere on the board

Notes on the sheet:
Temperature sensor

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
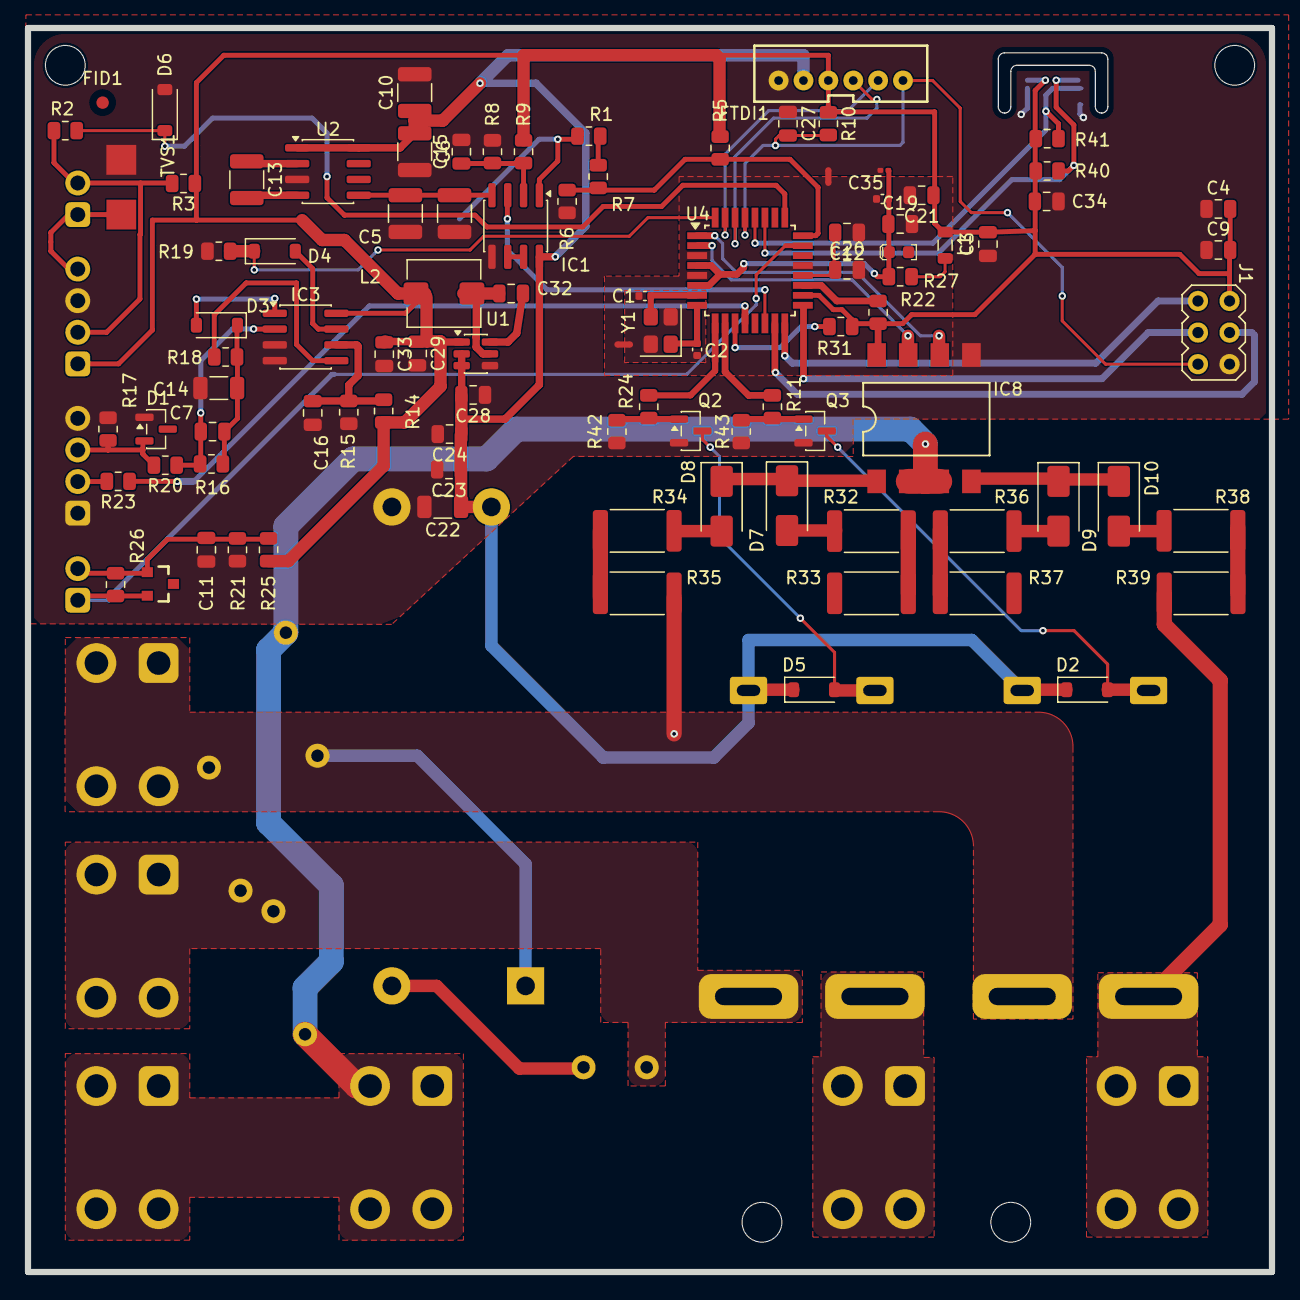
[picture p9: board evse.kicad_pcb from above]

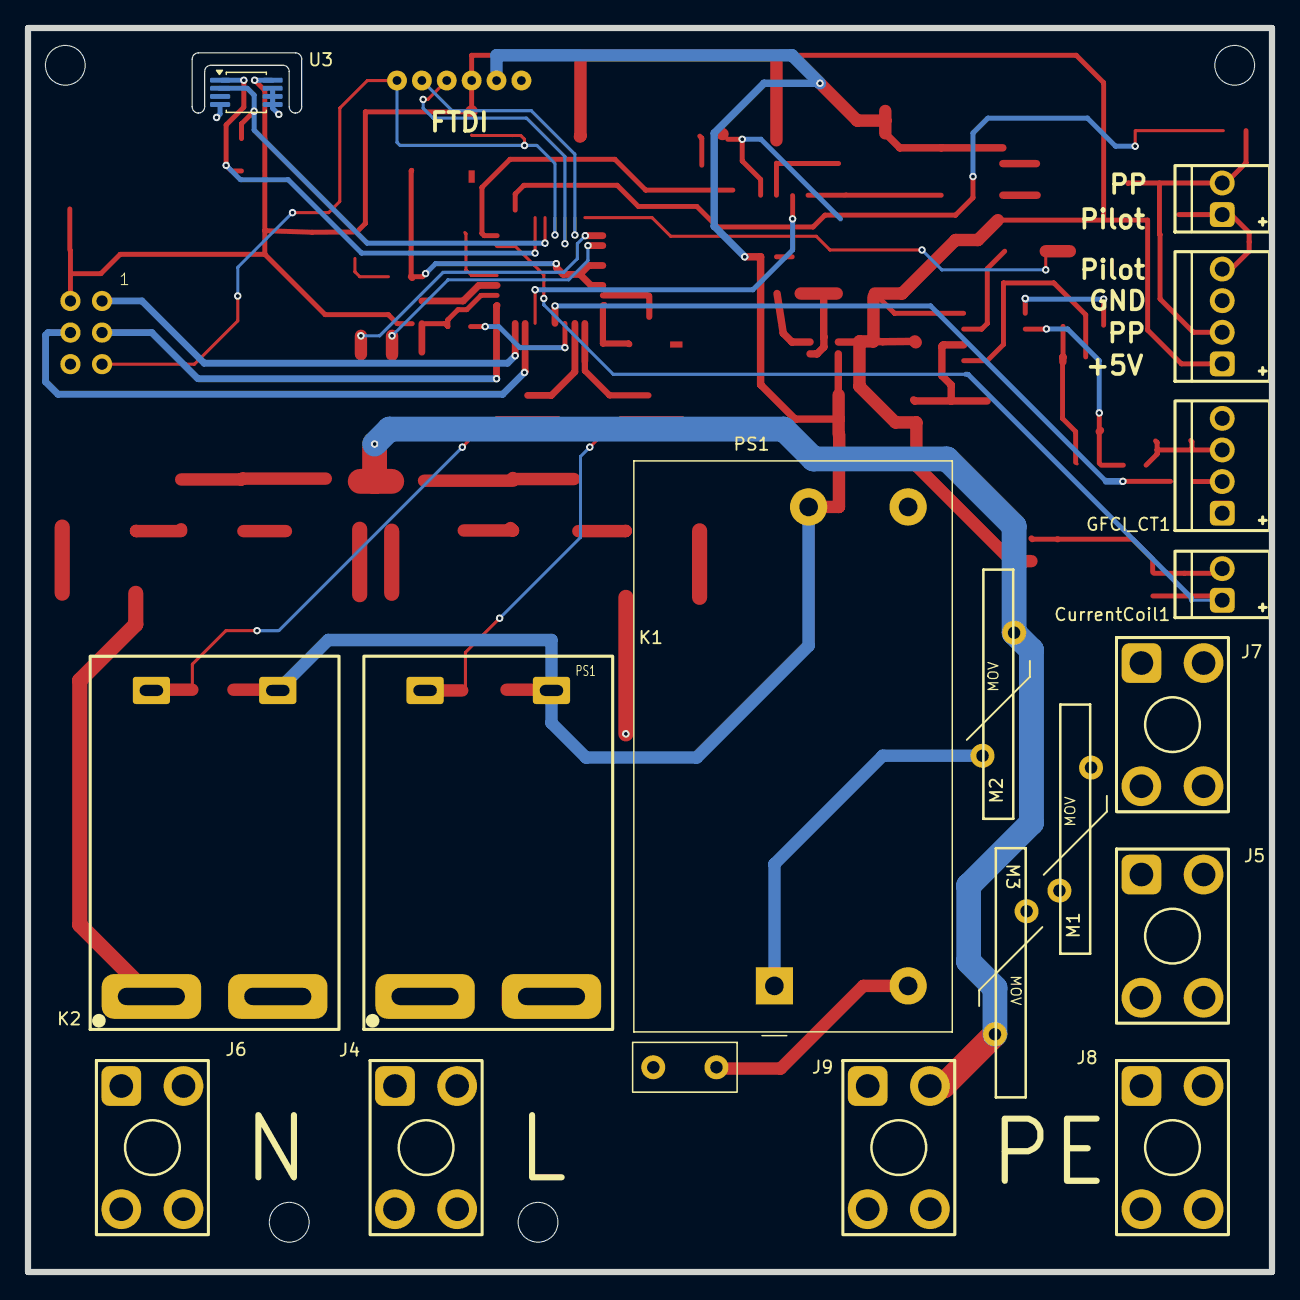
[picture p10: board evse.kicad_pcb from below]

Board: 2 copper layers, 100.0 x 100.0 mm, 117 parts (20 on the bottom side), 69 nets.

Other parts of the board:
UNK_HOLE_1, UNK_HOLE_1#2, UNK_HOLE_1#3: dummyfp1
