artashesamatuni/coreEVSE/(commit log)

2026-09-17 Organize OpenEVSE hardware and firmware sources
    [evse.kicad_pcb, evse.kicad_sch]
2026-09-17 Add DL-CT08CL19 GFCI transformer
    [evse.kicad_pcb, evse.kicad_sch]
2026-09-18 from home
    [evse.kicad_pcb, evse.kicad_sch]
2026-09-18 parts added
    [evse.kicad_pcb, evse.kicad_sch]
2026-09-23 Consolidate KiCad libraries and remove obsolete backups
    [evse.kicad_pcb, evse.kicad_sch]
2026-09-24 fix PCB
    [evse.kicad_pcb]
2026-09-25 Remove obsolete PCB synchronization script
2026-09-25 fix Y1
    [evse.kicad_pcb, evse.kicad_sch]
2026-09-25 fix SH3
    [evse.kicad_pcb, evse.kicad_sch]
2026-09-25 Add mandatory schematic TODO list
